ostojaatanasijevic/big_muff_pi/README.md

# TPI pedals - BMF

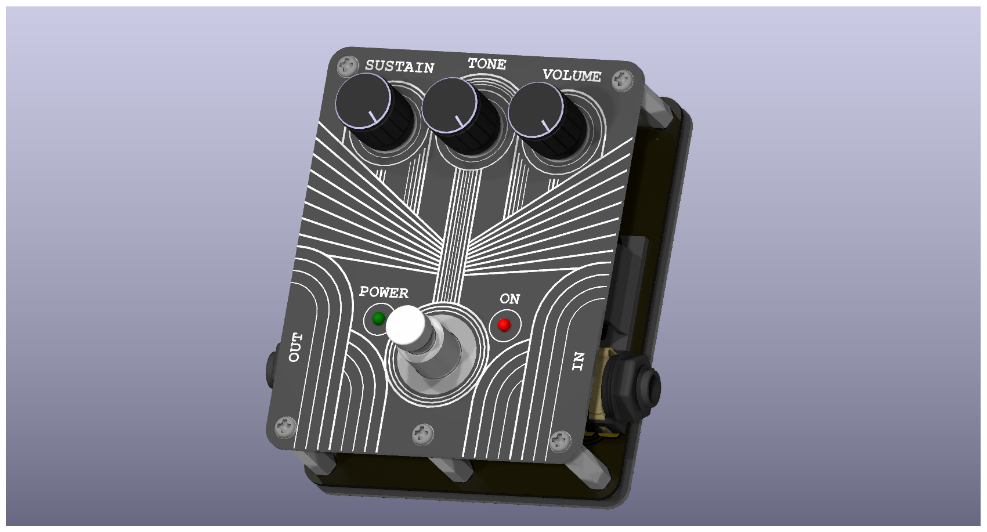
[picture p1: big_muff_pi/big_muff_pi_side.png]
side_view

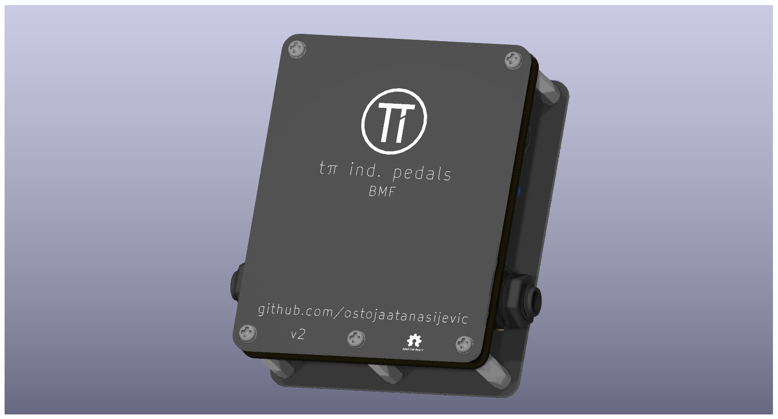
[picture p2: big_muff_pi/big_muff_pi_bottom.png]
top_view


## Schematic
schematic
