ostojaatanasijevic/big_muff_pi/big_muff_pi/big_muff_pi_top.png

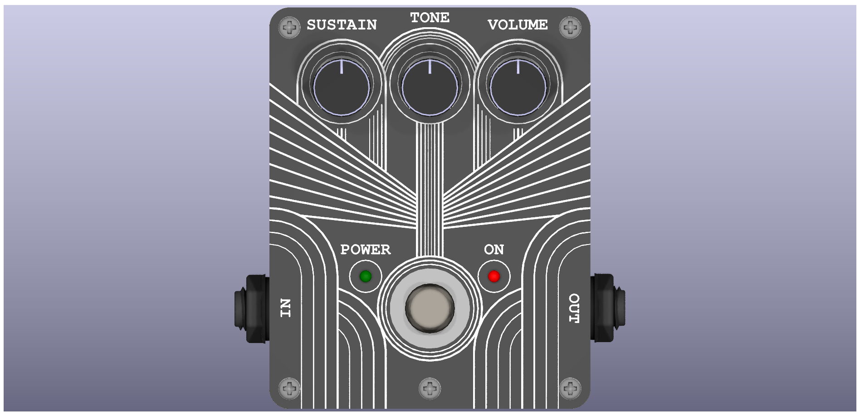
big_muff_pi/big_muff_pi_top.png
