ostojaatanasijevic/big_muff_pi/big_muff_pi_front_plate/big_muff_pi_front_plate.step

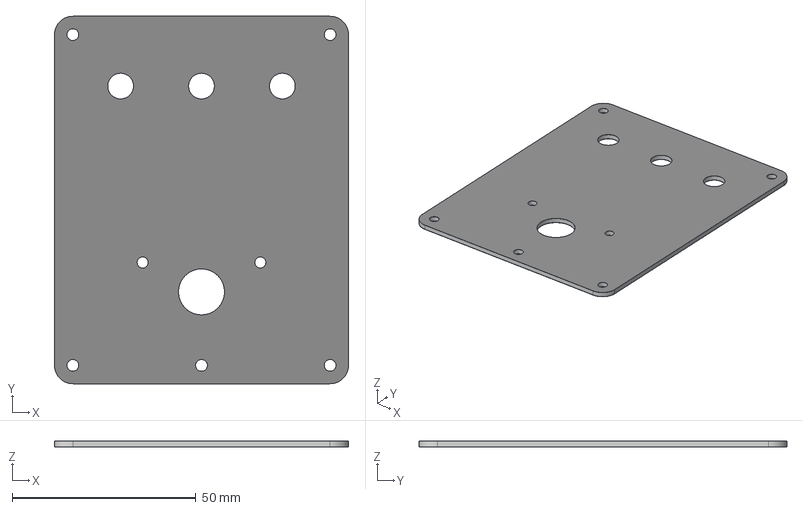
[picture p5: CAD file, 2025-05-10]
big_muff_pi_front_plate/big_muff_pi_front_plate.step
80.0 x 100.0 x 1.61 mm
big_muff_pi_front_plate_soldermask
big_muff_pi_front_plate_PCB
