ostojaatanasijevic/big_muff_pi/bottom_plate.step

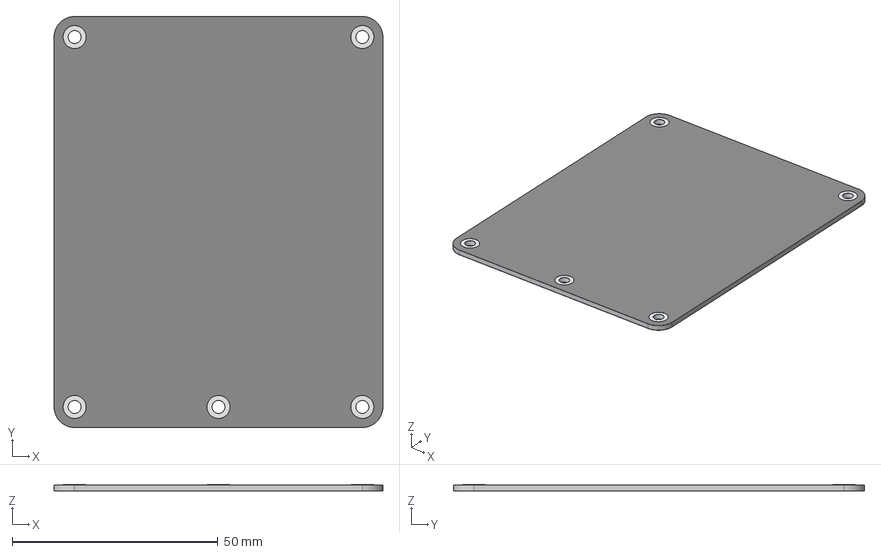
[picture p6: CAD file, 2025-05-22]
bottom_plate.step
80.0 x 100.0 x 1.64 mm
big_muff_pi_bottom_plate_pad
big_muff_pi_bottom_plate_silkscreen
big_muff_pi_bottom_plate_soldermask
big_muff_pi_bottom_plate_PCB
