ostojaatanasijevic/big_muff_pi/big_muff_pi_bottom_plate/switch.STEP

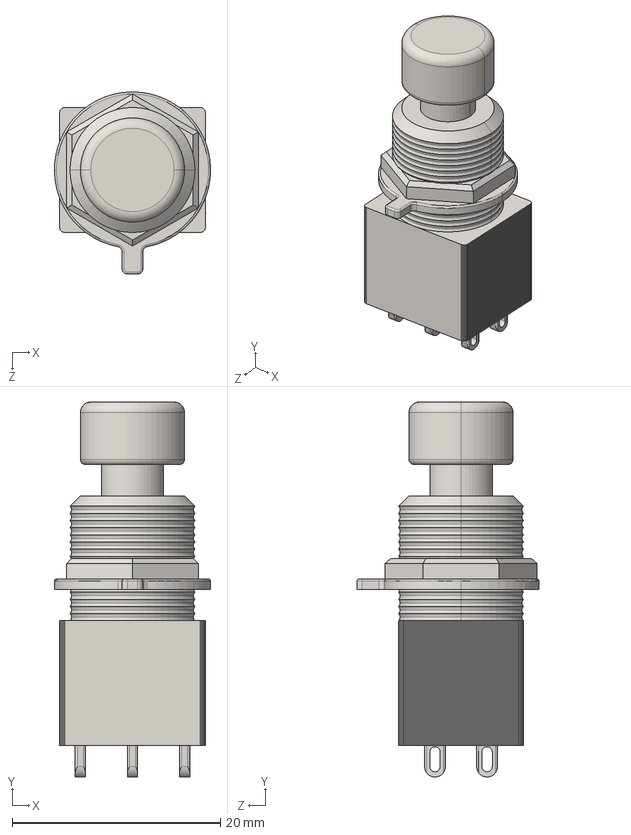
[picture p7: CAD file, 2025-05-06]
big_muff_pi_bottom_plate/switch.STEP
15.0 x 36.0 x 17.5 mm
