ostojaatanasijevic/big_muff_pi/big_muff_pi_bottom_plate/9V-battery.stp

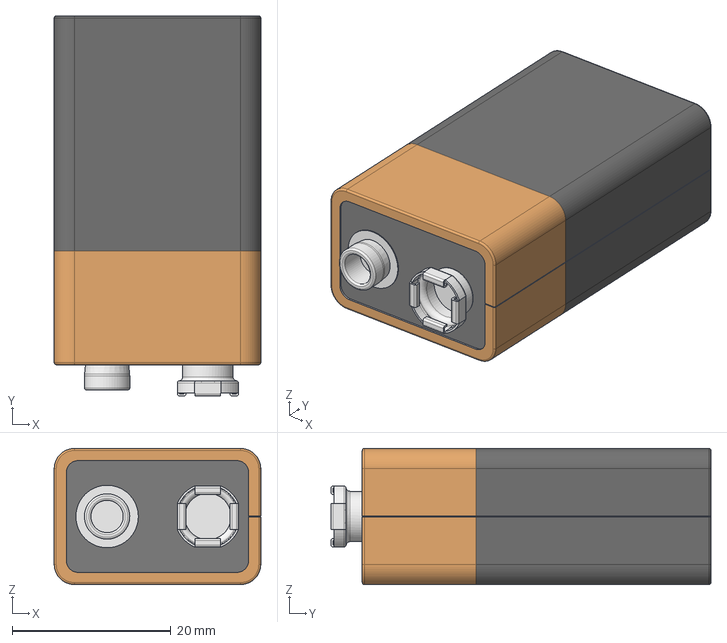
[picture p8: CAD file, 2025-05-06]
big_muff_pi_bottom_plate/9V-battery.stp
26.0 x 47.9 x 17.1 mm
