ostojaatanasijevic/big_muff_pi/big_muff_pi_bottom_plate/3-d-nmj6hhd2.stp

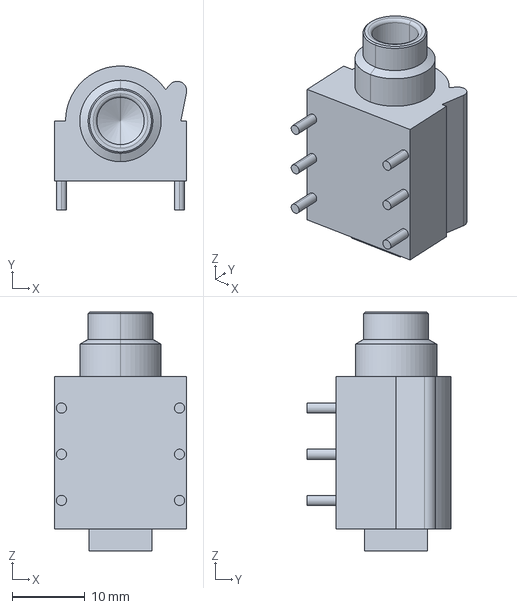
[picture p10: CAD file, 2025-04-03]
big_muff_pi_bottom_plate/3-d-nmj6hhd2.stp
18.2 x 19.8 x 32.9 mm
