ostojaatanasijevic/big_muff_pi/big_muff_pi/simulations/grec.asc

M1: nmos; AO6408
M2: nmos; AO6408
M3: pmos; AO6407
M4: pmos; AO6407
R1: res; 100
V1: voltage; SINE(0 9 100)
Named nets: 0
.tran 1
