ostojaatanasijevic/big_muff_pi/(commit log)

2025-04-01 Estetics finalized.
    [big_muff_pi.kicad_pcb, big_muff_pi.kicad_sch]
2025-04-01 Only routing left.
    [big_muff_pi.kicad_pcb, big_muff_pi.kicad_sch]
2025-04-02 Lib sync.
    [big_muff_pi.kicad_pcb, big_muff_pi.kicad_sch]
2025-04-03 New switch
    [big_muff_pi.kicad_pcb, big_muff_pi.kicad_sch, switch.STEP]
2025-04-03 poredjane komponente
    [big_muff_pi.kicad_pcb]
2025-04-03 rutiranje v1
    [big_muff_pi.kicad_pcb]
2025-04-03 rutiranje v2.
    [big_muff_pi.kicad_pcb]
2025-04-03 Tiny changes.
    [big_muff_pi.kicad_pcb]
2025-04-05 Updated library.
    [9V-battery.stp, big_muff_pi.kicad_pcb, big_muff_pi.kicad_sch]
2025-04-05 Production files v1.
    [big_muff_pi.kicad_pcb, bom.csv, designators.csv, positions.csv]
2025-04-20 Rotated 6.35 pins, switched connector positions, switched LED.
    [big_muff_pi.kicad_pcb, big_muff_pi.kicad_sch]
2025-05-05 Added IDC, added front plate.
    [big_muff_pi.kicad_pcb, big_muff_pi.kicad_sch, bom.csv, designators.csv, positions.csv]
2025-05-05 Top plate work.
2025-05-05 Led done
    Led done
2025-05-05 Added PMOS.
    [big_muff_pi.kicad_sch]
2025-05-05 Added the full wave rectifier.
    [big_muff_pi.kicad_sch]
2025-05-06 Renamed because woke.
    [3-d-nmj6hhd2.stp, 9V-battery.stp, NMJ6HFD2-AU--3DModel-STEP-418109.STEP, big_muff_pi_front_plate.kicad_pcb, big_muff_pi_front_plate.kicad_sch, big_muff_pi_front_plate.step, switch.STEP]
2025-05-06 Returned to normal because trad.
    [3-d-nmj6hhd2.stp, 9V-battery.stp, NMJ6HFD2-AU--3DModel-STEP-418109.STEP, big_muff_pi_front_plate.kicad_pcb, big_muff_pi_front_plate.kicad_sch, big_muff_pi_front_plate.step, switch.STEP]
2025-05-06 Inputs rotated, power conn moved, spacers updated.
    [big_muff_pi.kicad_pcb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]
2025-05-09 Pots rotated, more space for the battery.
    [big_muff_pi.kicad_pcb, big_muff_pi_front_plate.kicad_pcb]
2025-05-10 Potentiometers checked, LED updated
    [big_muff_pi.kicad_pcb, big_muff_pi.kicad_sch, big_muff_pi_front_plate.kicad_pcb, big_muff_pi_front_plate.kicad_sch]
2025-05-10 Added the bottom plate.
    [3-d-nmj6hhd2.stp, 9V-battery.stp, NMJ6HFD2-AU--3DModel-STEP-418109.STEP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]
2025-05-10 small work
    [big_muff_pi.kicad_pcb, big_muff_pi.kicad_sch, big_muff_pi_front_plate.step, bottom_plate.step]
2025-05-11 Larger logo, bottom plate silkscreen.
    [big_muff_pi_bottom_plate.kicad_pcb, bottom_plate.step]
2025-05-12 Solid pro grass lol.
    [big_muff_pi.kicad_pcb]
2025-05-13 Updated 3d models.
    [big_muff_pi_bottom_plate.step, bottom_plate.step]
2025-05-13 Update 3d model.
    [bottom_plate.step]
2025-05-13 Gen 3d body script.
    [bottom_plate.step]
2025-05-19 Front plate update.
    [big_muff_pi_front_plate.kicad_pcb, big_muff_pi_front_plate.kicad_sch]
2025-05-19 anin update.
    [big_muff_pi.kicad_pcb]
2025-05-19 small mods.
    [big_muff_pi.kicad_pcb, big_muff_pi.kicad_sch]
2025-05-21 New switch, fixed courtyards.
    [big_muff_pi.kicad_pcb, big_muff_pi.kicad_sch]
2025-05-21 Big muff pi, new connector position.
    [big_muff_pi_front_plate.kicad_pcb, big_muff_pi_front_plate.kicad_sch]
2025-05-21 Updated traces.
    [big_muff_pi.kicad_pcb]
2025-05-21 Main board almost ready.
    [big_muff_pi.kicad_pcb, big_muff_pi.kicad_sch]
2025-05-21 Front plate update, componets created.
    [big_muff_pi_front_plate.kicad_pcb, big_muff_pi_front_plate.kicad_sch]
2025-05-21 Updated 3D bodies.
    [bottom_plate.step]
2025-05-21 Front plate trace done.
    [big_muff_pi_front_plate.kicad_pcb]
2025-05-22 Rounded traces.
    [big_muff_pi.kicad_pcb]
2025-05-22 Rounded traces za front plate.
    [big_muff_pi_front_plate.kicad_pcb]
2025-05-22 2.2k LED.
    [big_muff_pi.kicad_pcb, big_muff_pi.kicad_sch]
2025-05-22 Pot labels.
    [big_muff_pi_front_plate.kicad_pcb]
2025-05-22 dfasdf dfasdf
    [big_muff_pi.kicad_pcb, big_muff_pi.kicad_sch, big_muff_pi_front_plate.kicad_pcb]
2025-05-24 Production ready.
    [big_muff_pi.csv, big_muff_pi.kicad_pcb, big_muff_pi_bottom_plate.kicad_pcb, big_muff_pi_front_plate.kicad_pcb, bom.csv, designators.csv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]
